JabawokJayUK/ProjectHaloUK/docs/gallery.md

# Gallery

## Fitted

The finished article — halo rings running as daytime running lights on a 159.

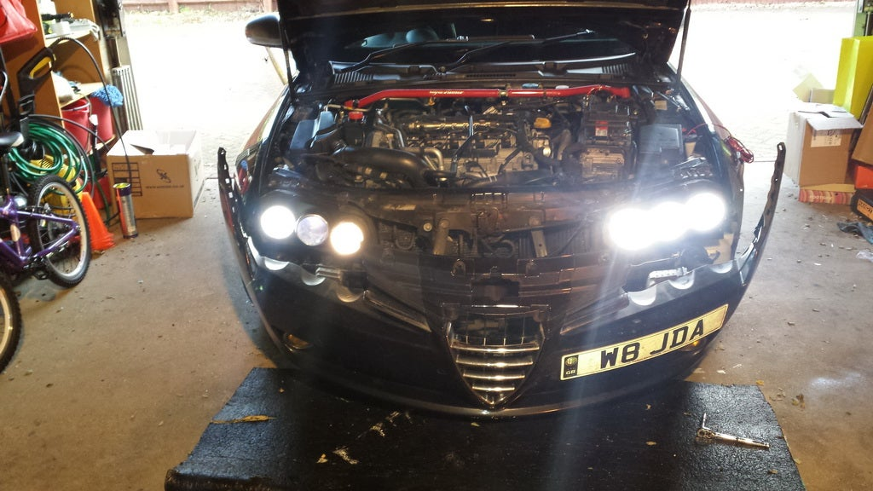
[picture p13: docs/images/gallery/fitted-01.jpg]
Fitted 1

Fitted 2
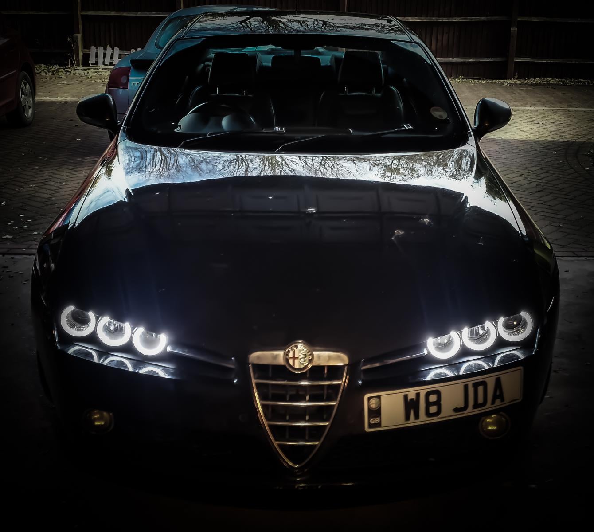
[picture p14: docs/images/gallery/fitted-03-hdr.jpg]
Fitted 3

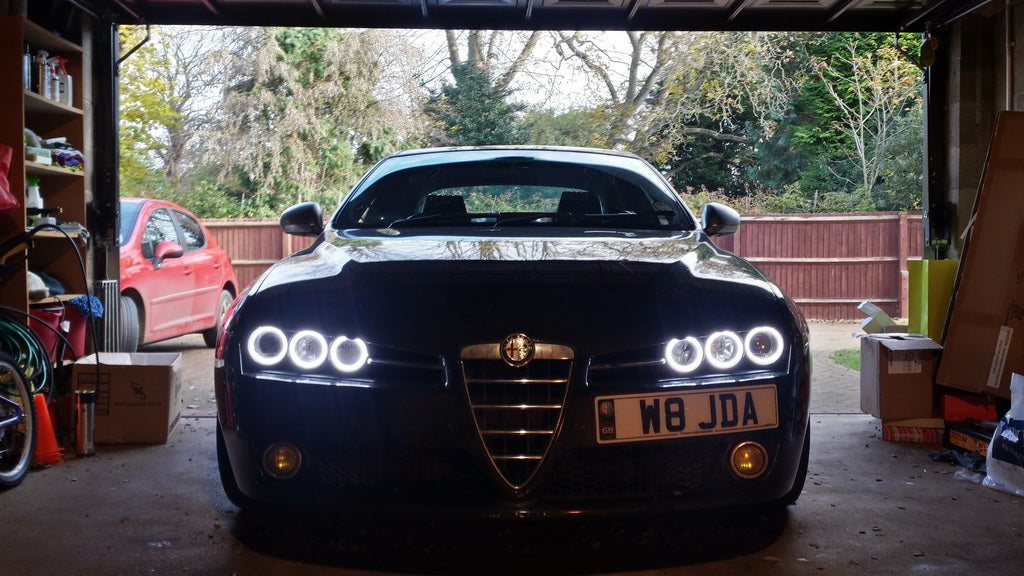
[picture p15: docs/images/gallery/fitted-04-hdr.jpg]
Fitted 4

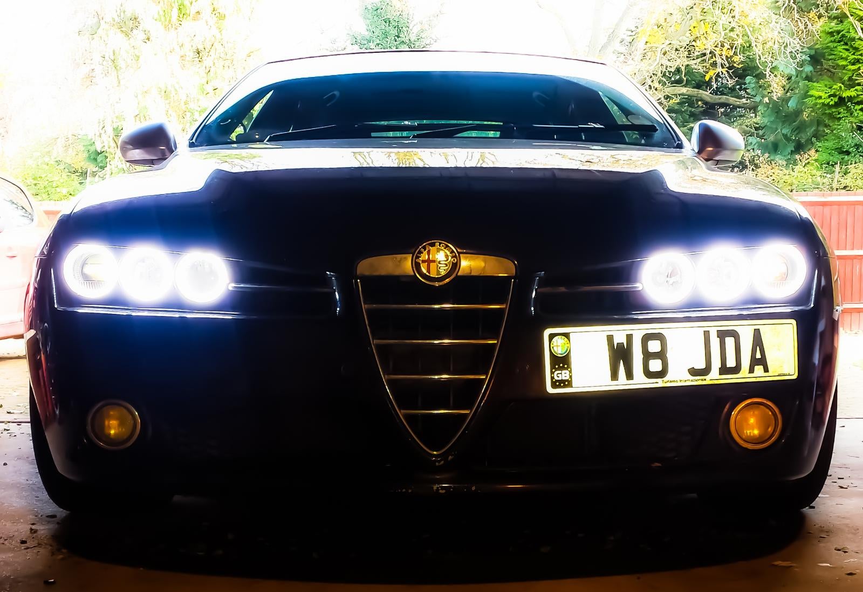
[picture p16: docs/images/gallery/fitted-05.jpg]
Fitted 5

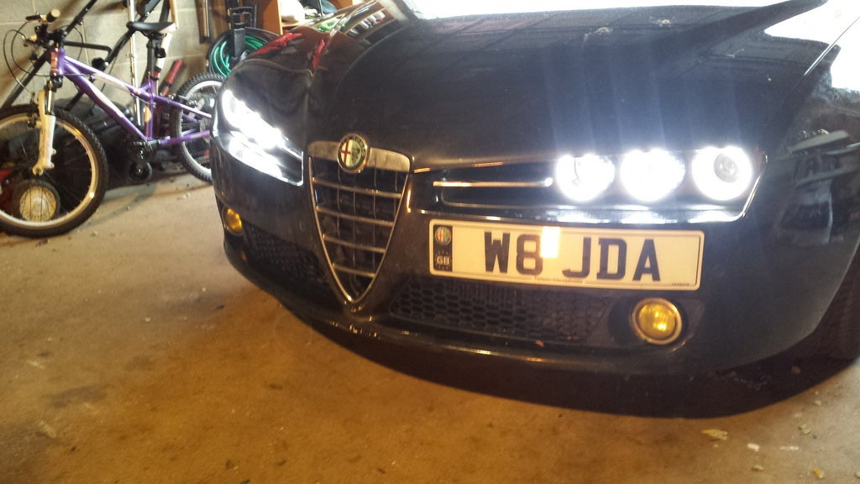
[picture p17: docs/images/gallery/fitted-06.jpg]
Fitted 6

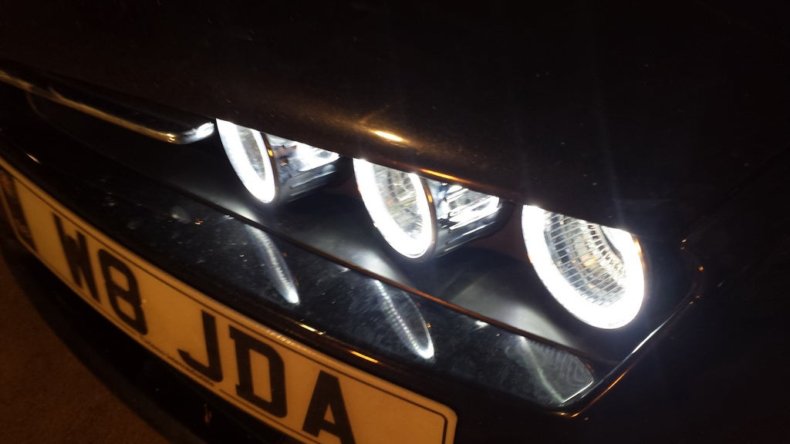
[picture p18: docs/images/gallery/fitted-07.jpg]
Fitted 7

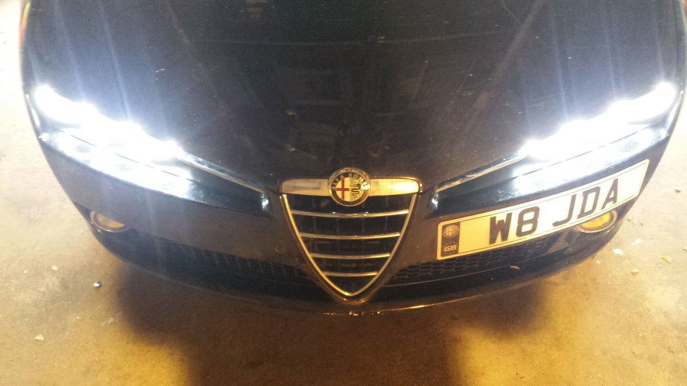
[picture p19: docs/images/gallery/fitted-08.jpg]
Fitted 8


## Development

Early ring testing in the dark, before any controller existed.

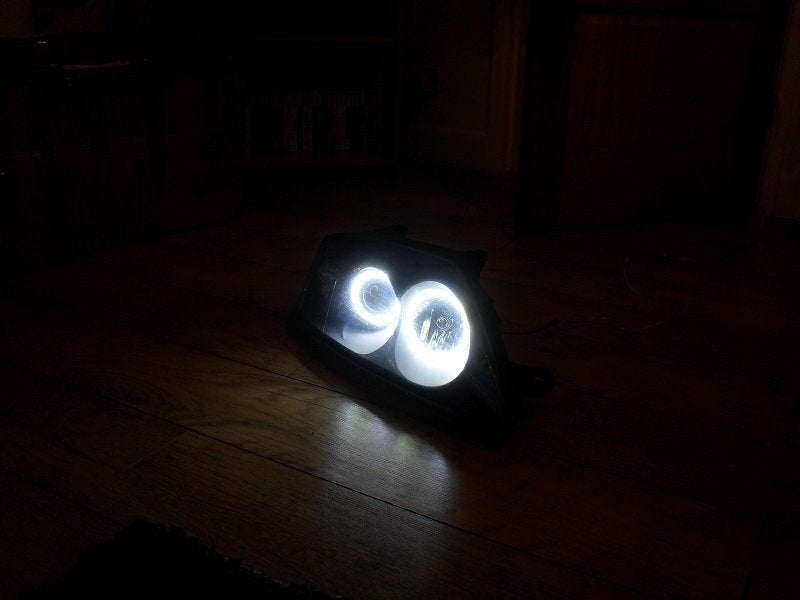
[picture p20: docs/images/gallery/early-ring-test-dark.jpg]
Early ring test


Component parts laid out.

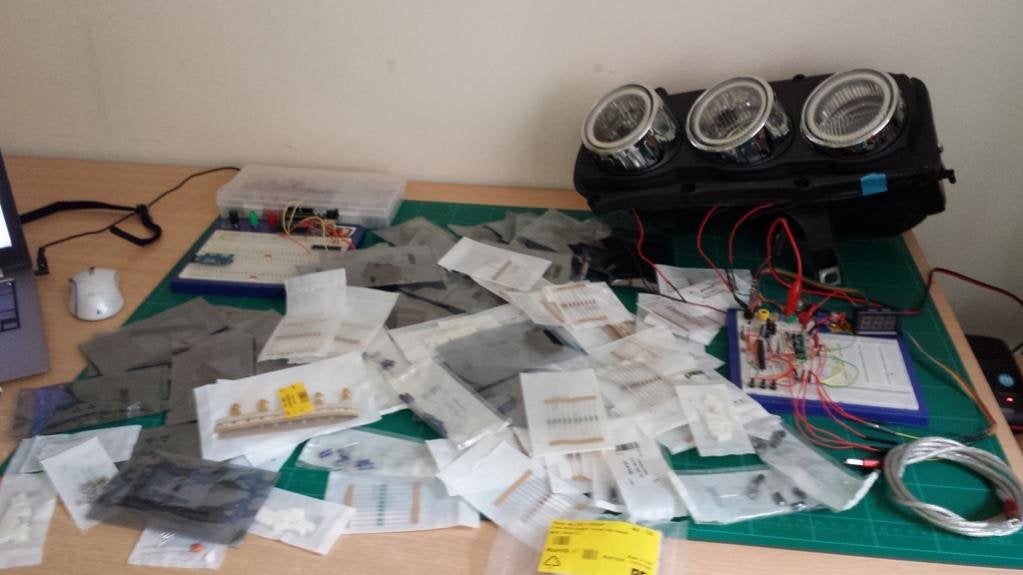
[picture p21: docs/images/controller/component-parts.jpg]
Component parts


Bench build — controllers wired up with rings for testing.

Bench build
Controllers and rings

## Hardware

v1 schematic, drawn in DesignSpark.

v1 schematic

v1 PCB layout.

v1 PCB

Controller I/O layout.

I/O layout

Firmware under development.

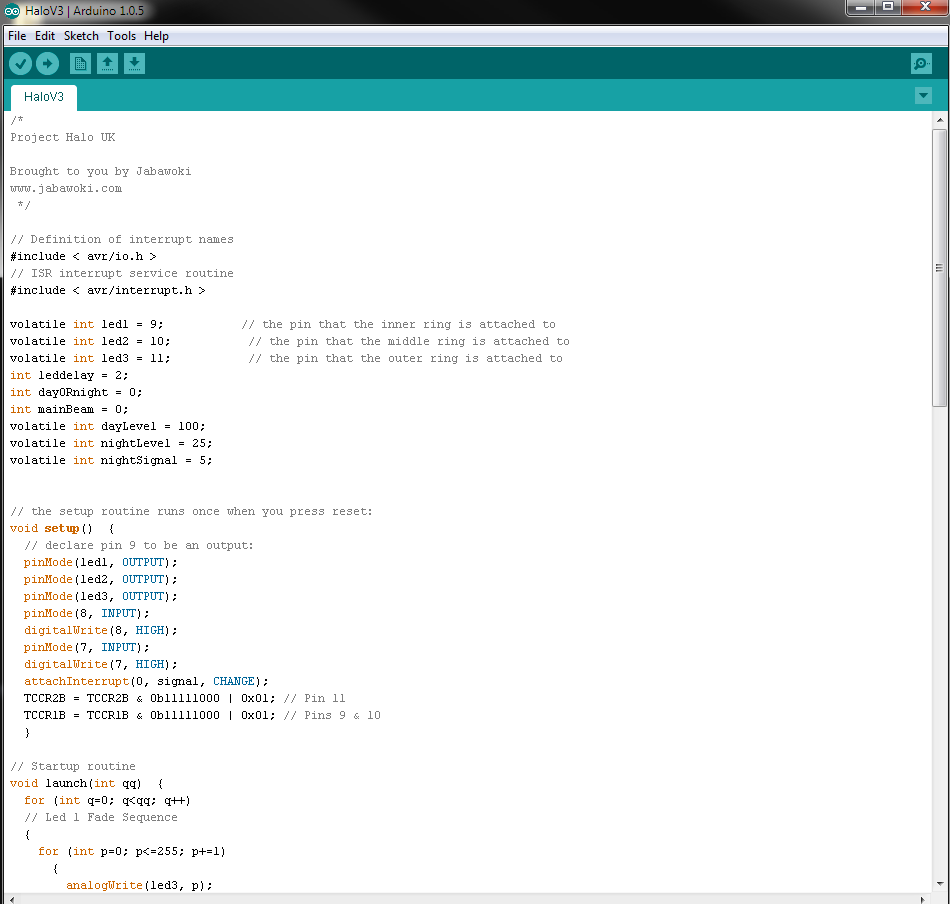
[picture p22: docs/images/controller/v1-code-screenshot.png]
Code


## Installation

Donor headlights, ready to be worked on.

Donor headlights

Bumper off, headlight location exposed.

Bumper removed
Headlight location

Power supply and relay installed in the engine bay.

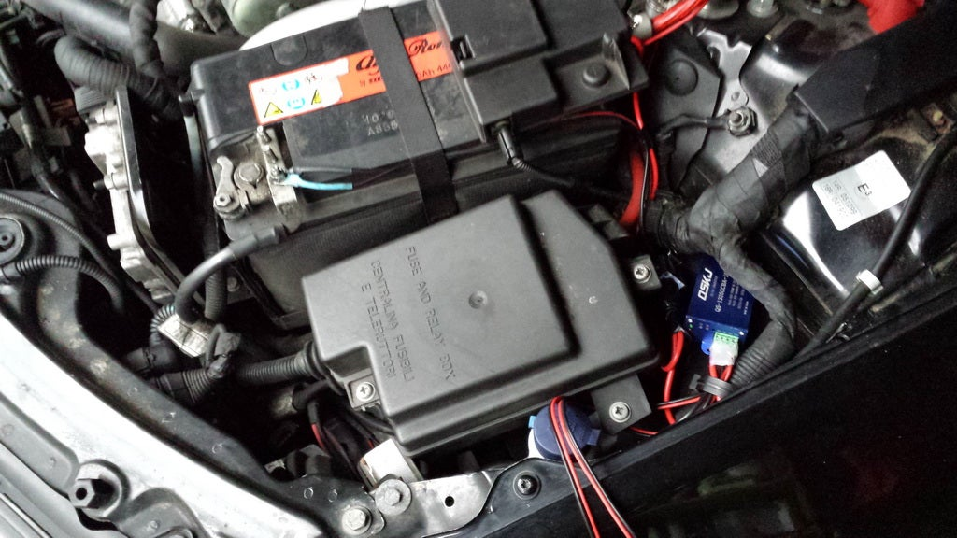
[picture p23: docs/images/power/engine-bay-psu-installed.jpg]
PSU installed

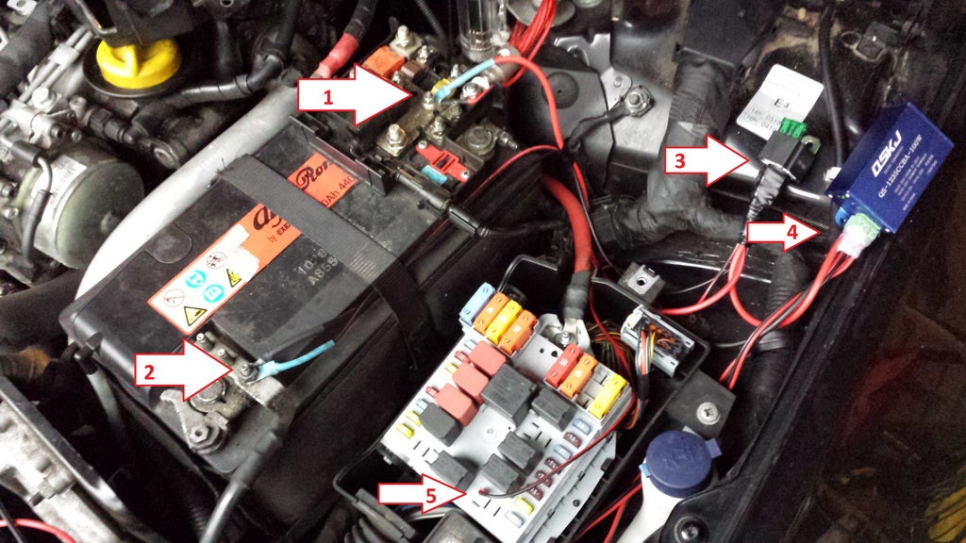
[picture p24: docs/images/power/engine-bay-annotated.jpg]
Engine bay annotated


## Camera originals

Full-resolution photos from the original shoots, in
[`images/originals/`](images/originals/).

### The boards

The bare v1 board, populated.

Bare board

A finished controller in its ABS case.

Controller in case

The buck converter that feeds the controllers.

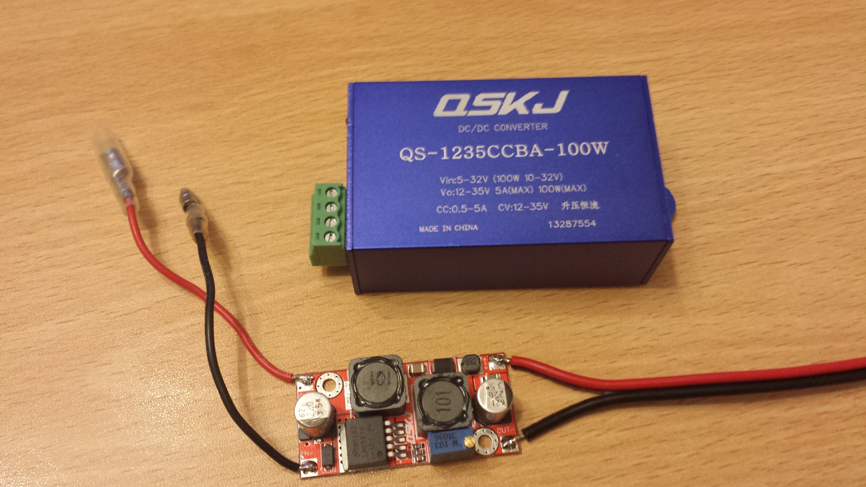
[picture p25: docs/images/originals/psu-buck-converter.jpg]
Buck converter


### Bench testing

Controllers and rings wired up on the bench.

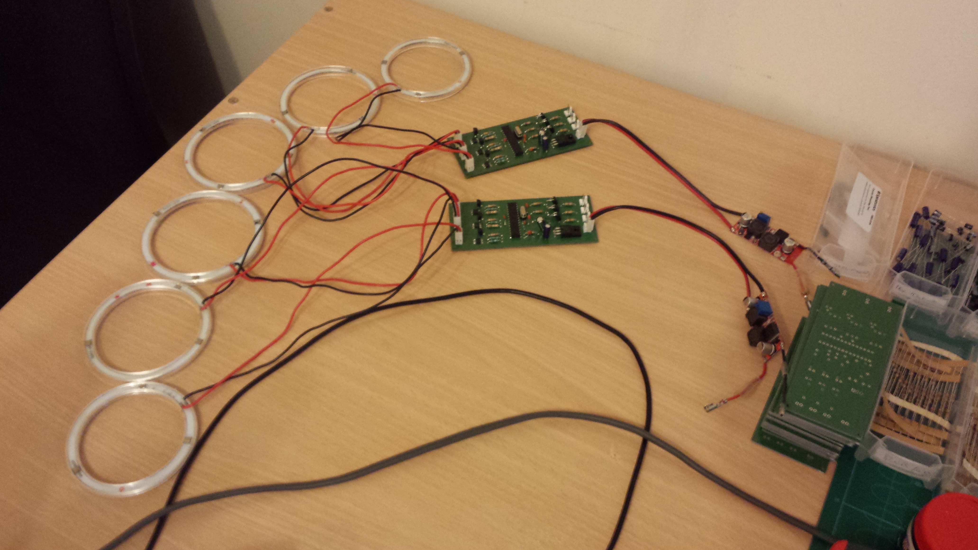
[picture p26: docs/images/originals/bench-rings-controllers.jpg]
Bench setup

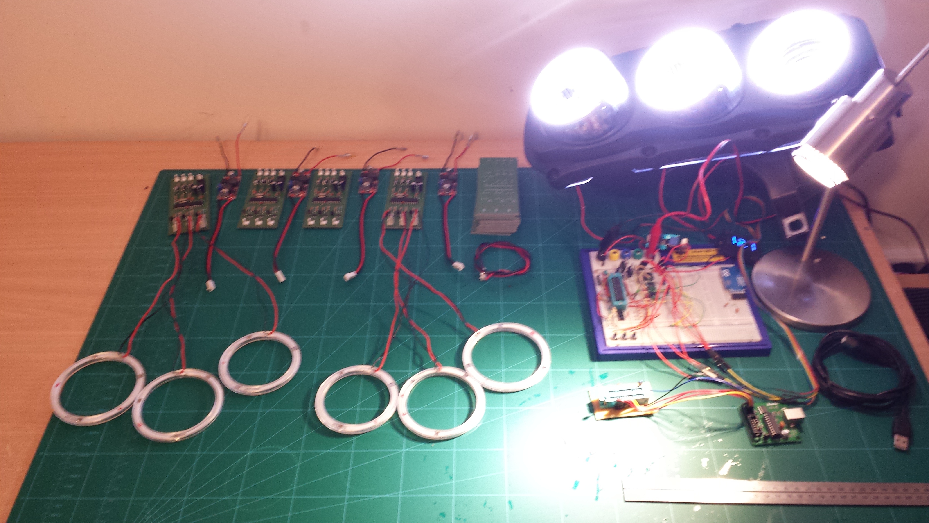
[picture p27: docs/images/originals/bench-rings-lit.jpg]
Rings lit

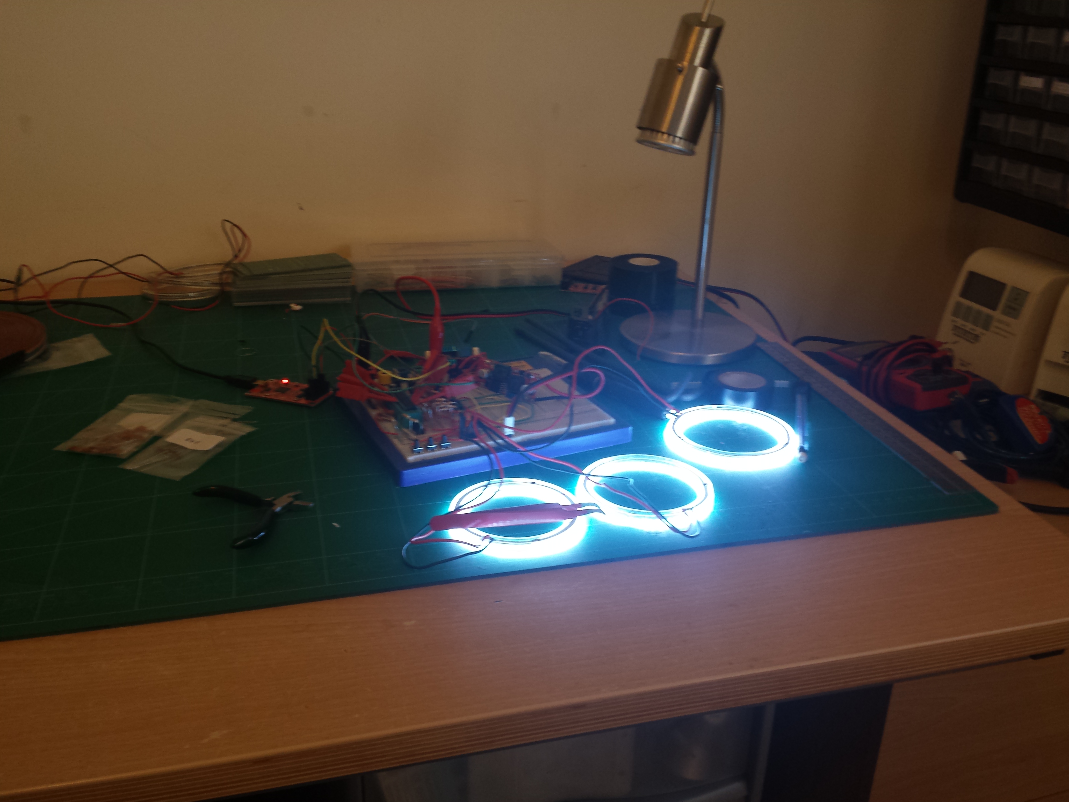
[picture p28: docs/images/originals/bench-test-lit.jpg]
Bench test lit


### Bumper off

The front bumper removed — the only way to reach the lower headlight mount.

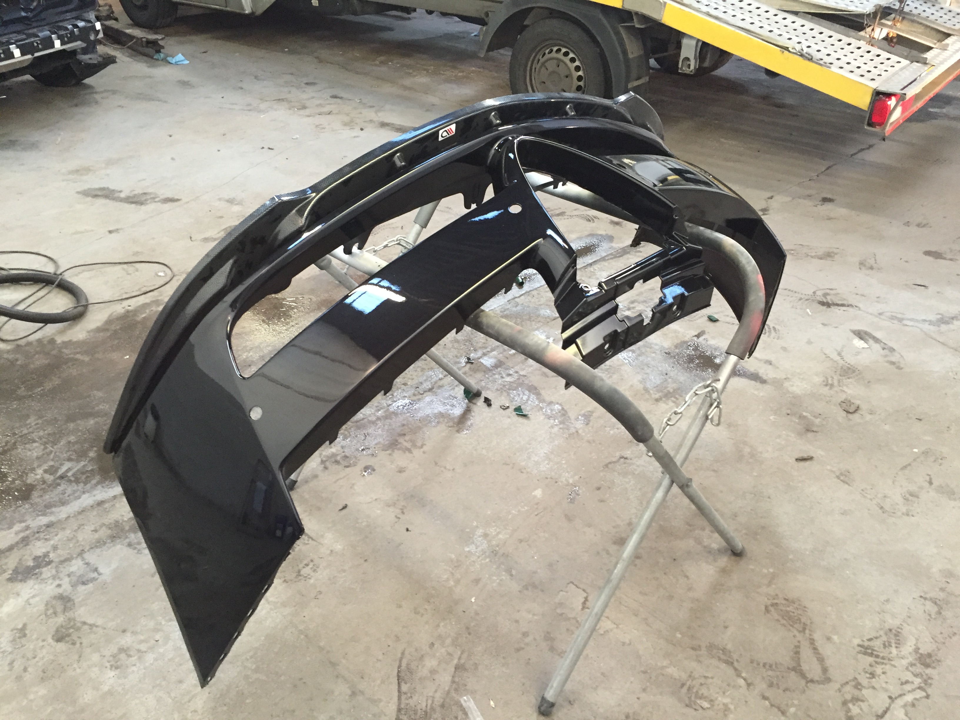
[picture p29: docs/images/originals/bumper-removed-01.jpg]
Bumper removed 1

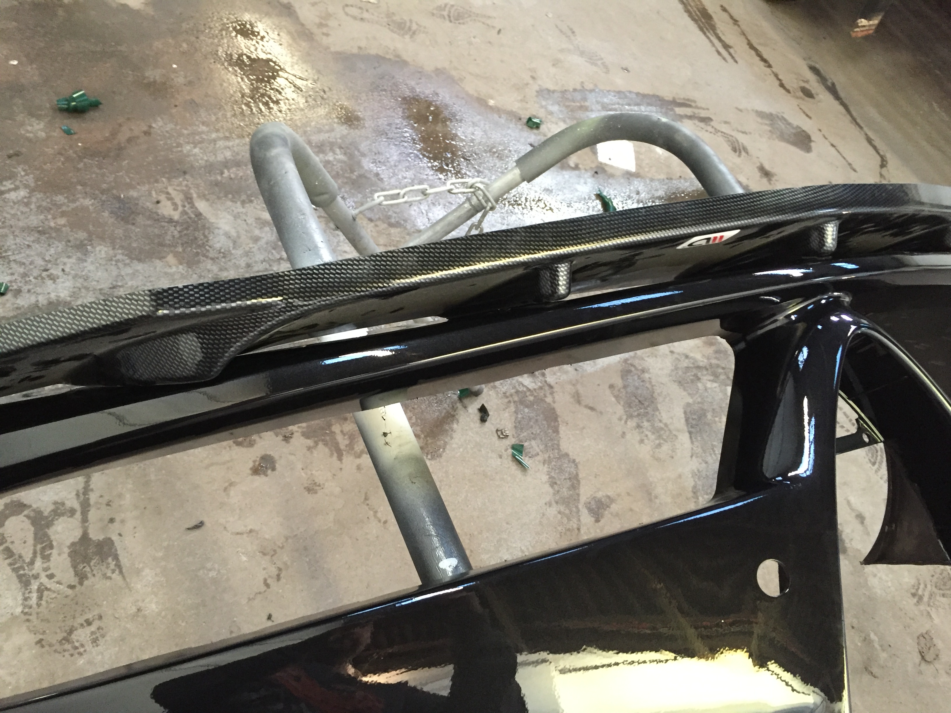
[picture p30: docs/images/originals/bumper-removed-02.jpg]
Bumper removed 2

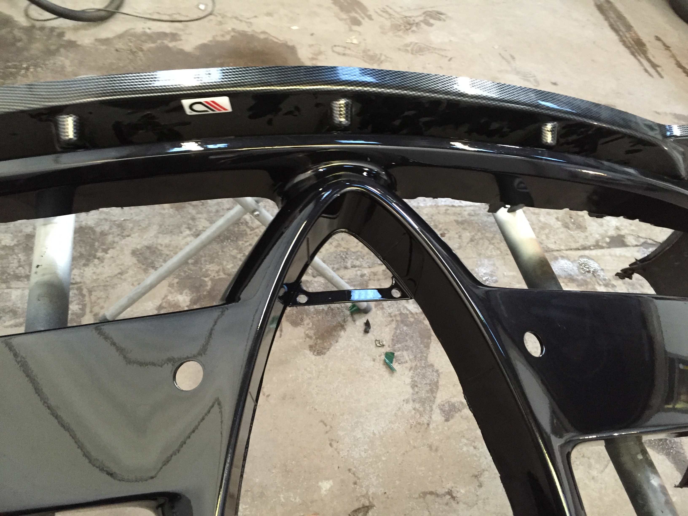
[picture p31: docs/images/originals/bumper-removed-03.jpg]
Bumper removed 3

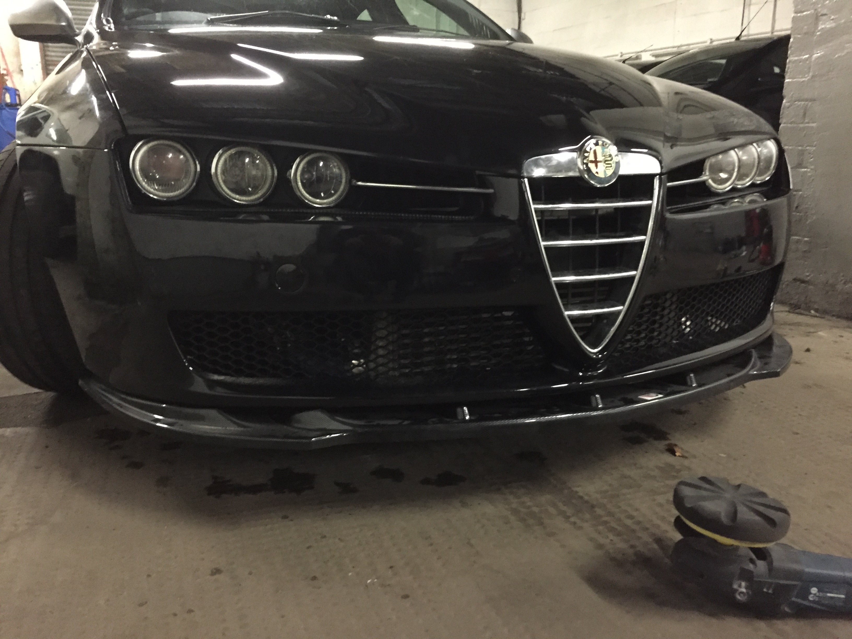
[picture p32: docs/images/originals/car-bumper-off-01.jpg]
Car with bumper off 1

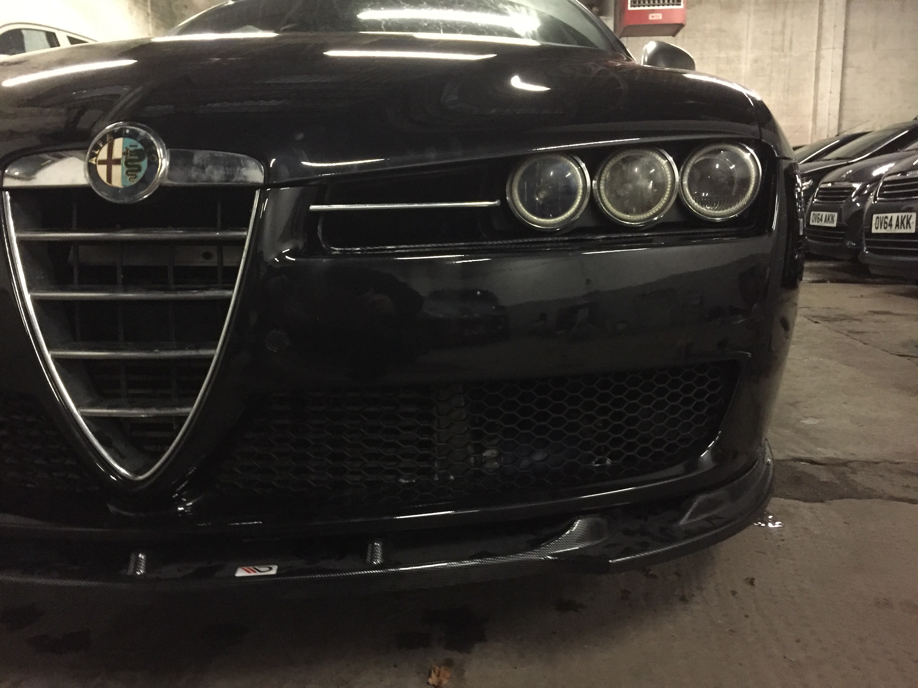
[picture p33: docs/images/originals/car-bumper-off-02.jpg]
Car with bumper off 2


### Fitted

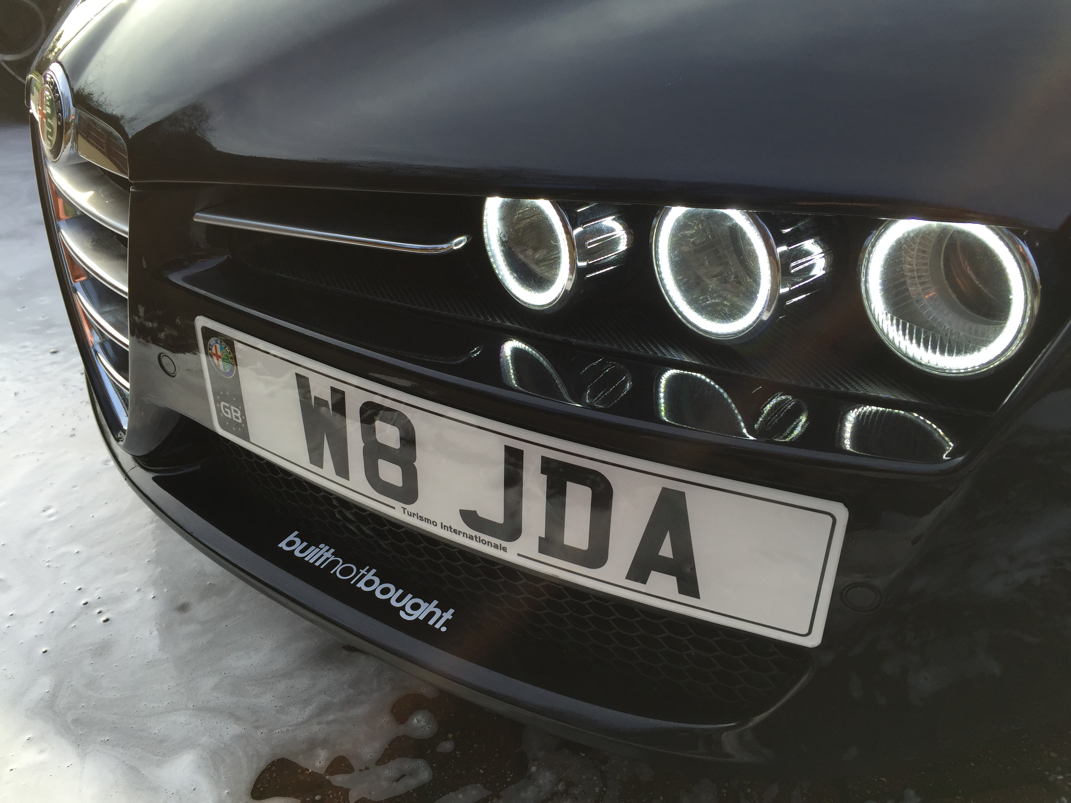
[picture p34: docs/images/originals/fitted-front-dusk.jpg]
Fitted, dusk

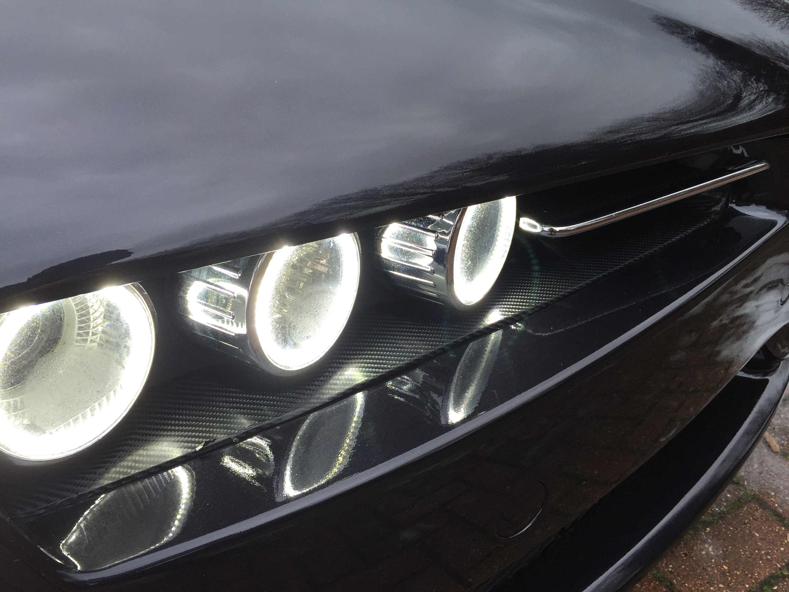
[picture p35: docs/images/originals/fitted-closeup-rings.jpg]
Close-up of rings

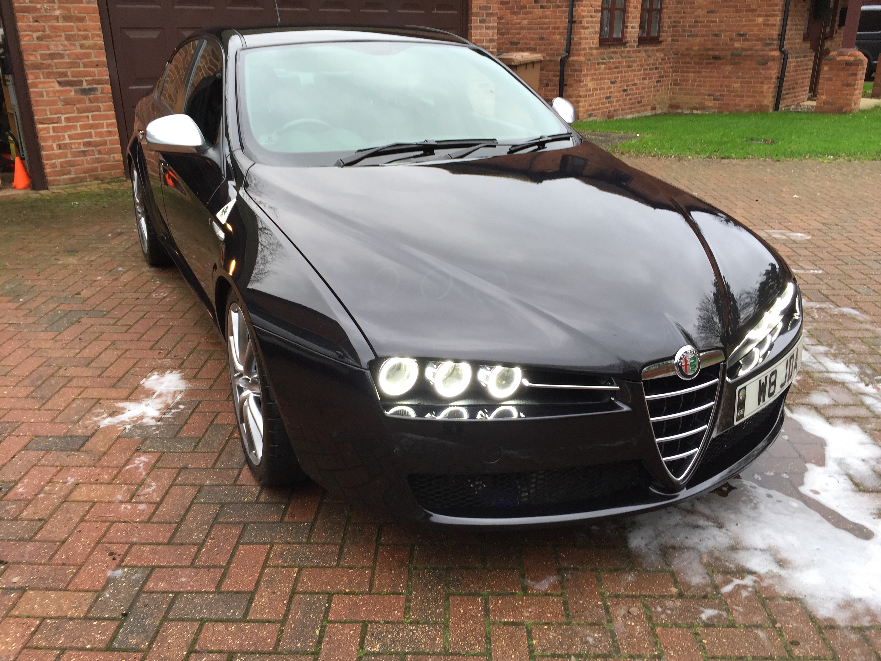
[picture p36: docs/images/originals/fitted-snow-wide.jpg]
Fitted in snow, wide

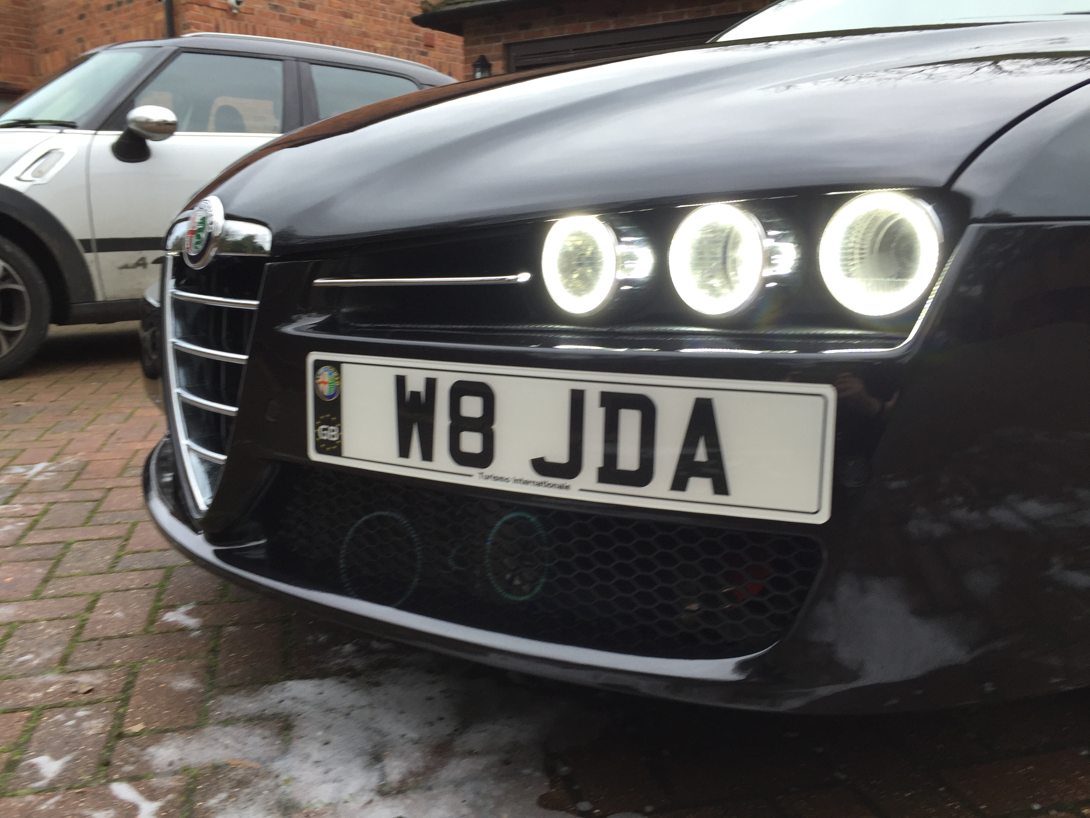
[picture p37: docs/images/originals/fitted-snow-front.jpg]
Fitted in snow, front

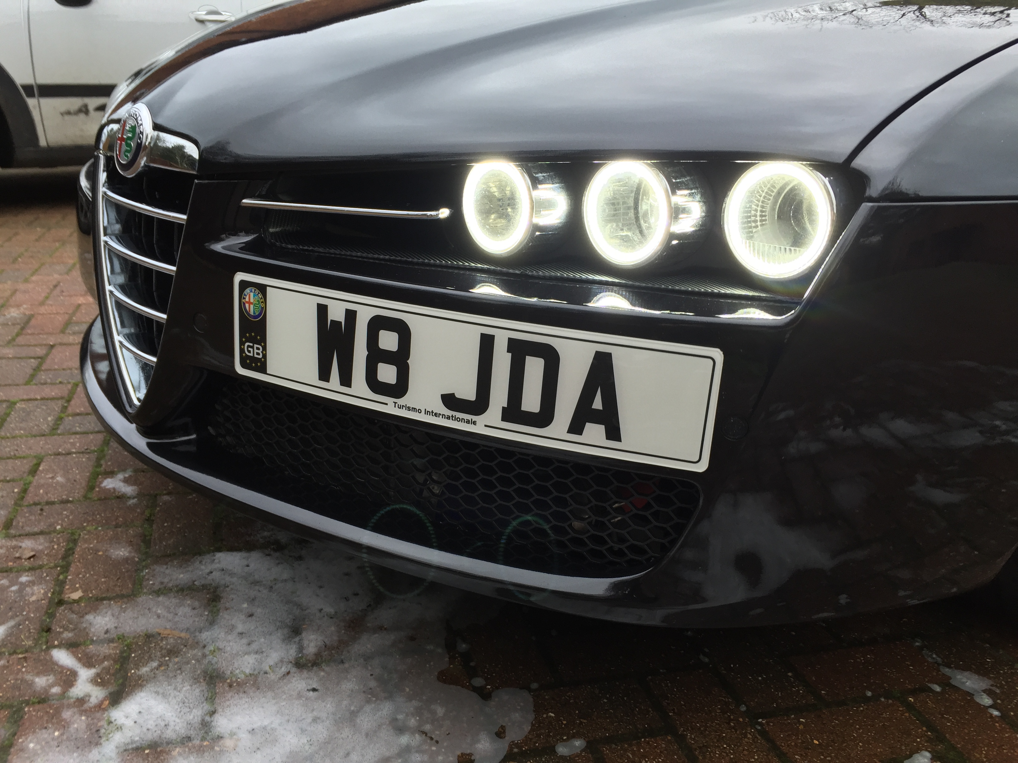
[picture p38: docs/images/originals/fitted-snow-plate.jpg]
Fitted in snow


## Ring colour reference

The difference between "white" (~5500 K) and "cold white" (~7000 K) rings.

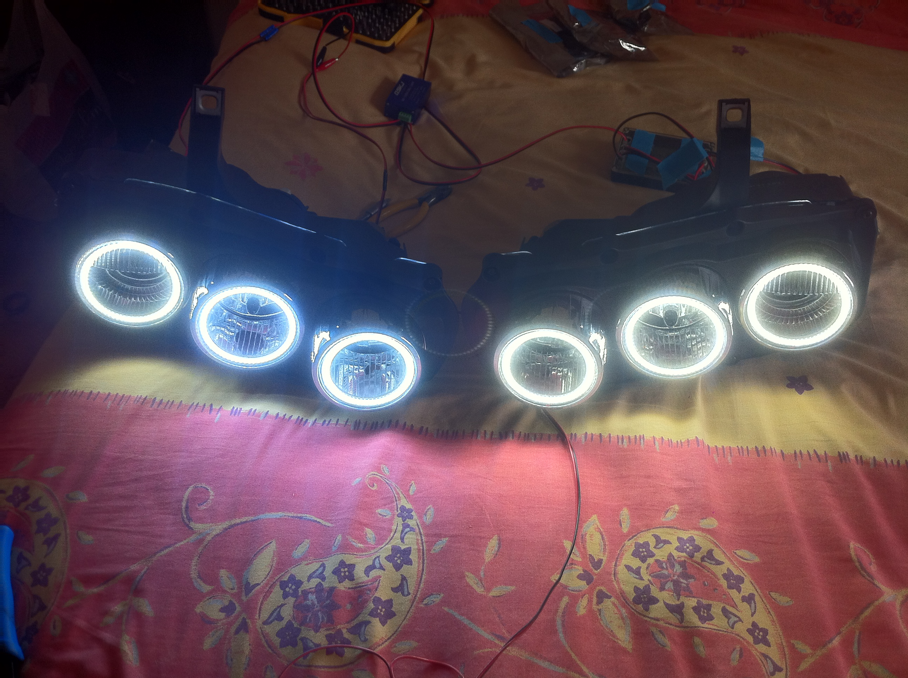
[picture p39: docs/images/gallery/ring-colour-temperature-comparison.jpg]
Ring colours


---

## Videos

Nine Project Halo videos are on YouTube — see [Videos](videos.md) for the full
list.

A community video by Coxy1, who worked out the headlight disassembly method:
[Alfa Romeo 159 Halo test](https://www.youtube.com/watch?v=qOf9f99d9EU).

---

*Photographs recovered from jabawoki.com and the
[Alfaowner.com build thread](https://www.alfaowner.com/threads/project-halo-the-159-brera-spider-halo-drl-project.314184/).
Images remain the copyright of their respective contributors.*
