JabawokJayUK/ProjectHaloUK/docs/videos.md

# Videos

Nine Project Halo videos, all on the [JayAbbott_UK YouTube channel](https://www.youtube.com/@JayAbbott_UK).

## Concept and alpha

Early bench work — getting the idea off the ground, before any custom hardware existed.

- [Project Halo — Alpha — Initial Concepts](https://www.youtube.com/watch?v=yZMHfKTUxSM)
- [Project Halo — Alpha — Getting the concepts together](https://www.youtube.com/watch?v=SdkW_1acpUQ)
- [Project Halo — Alpha — Getting the concepts together (v2)](https://www.youtube.com/watch?v=-Vzyds8_WEo)
- [Project Halo — Alpha Testing](https://www.youtube.com/watch?v=t6NNaXqVmHo)

## Effects and ring tests

The startup fade sequence, and the colour-temperature comparison that settled which rings to use.

- [Project Halo — Alpha — Startup effects](https://www.youtube.com/watch?v=248dNoFAD7A)
- [Project Halo — 6K Rings Test](https://www.youtube.com/watch?v=dSU7cvTWB_Q)
- [Project Halo — 8K Rings Test](https://www.youtube.com/watch?v=7mJIelXVpTg)

The 6000 K and 8000 K tests are worth watching back to back — 8000 K reads noticeably
bluer. See [Parts List](parts-list.md) for the ring sizes and the colour decision.

## On the car

- [Project Halo — On Car Test](https://www.youtube.com/watch?v=-ryPAMjl98U)

## Programming

Flashing a controller in place, without pulling the board out of its case.

- [Project Halo — In System Programming](https://www.youtube.com/watch?v=IiaWAieWZrA)

See [Firmware](firmware.md) for the ISP header pinout and the sketch itself.

## Third-party references

Headlight splitting is the stage most likely to go wrong, and watching someone
else do it first is worth the time. Links to useful videos by other people are
collected in the [Headlight Splitting](guides/headlight-splitting.md) guide.
