JabawokJayUK/ProjectHaloUK/hardware/3d-render.pdf

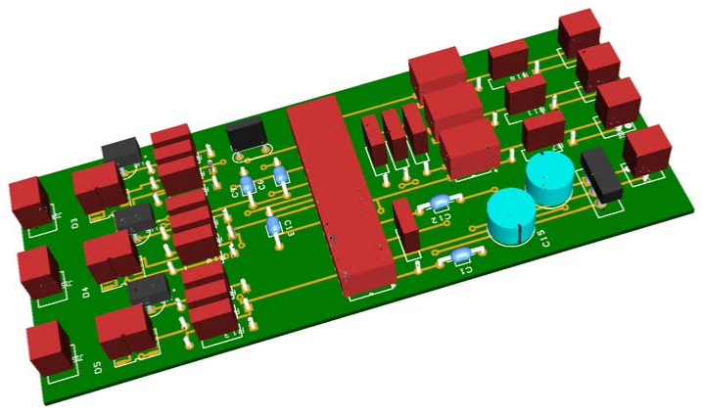
[picture p40: figure]
