JabawokJayUK/ProjectHaloUK/hardware/bom.xlsx

 |  |  |  |  |  |  |  |  | Estimate | Actual
Bill of Materials generated with DesignSpark PCB - www.DesignSpark.com/pcb |  |  |  |  |  |  |  | Cost to make 10 Sets of headlights | £1405.32 | £761.03
-------------------------------------------------------------------------- |  |  |  |  |  |  |  | Cost per set | £140.53 | £76.10
 |  |  |  |  |  |  |  | Cost per Headlight | £70.27 | £38.05
 |  |  |  |  |  |  |  |  |  |  |  |  | To make
Ref Name | Qty | Component | Value | Package | Manufacturer | MPN | Part Number | Description |  | VAT | Min Qty | Cost | 10 Sets of lights | Ordered | Actual Cost
RS Supply
U1 | 1 | 2N7000 |  | TO-92-3L | Fairchild Semiconductor | 2N7000 | 671-4733 | Trans MOSFET N-CH 60V 0.2A 3-Pin TO-92 | £0.08 | £0.02 | 20 | £1.87 | £1.87 | X | £202.39
U8 | 1 | 2N7000 |  | TO-92-3L | Fairchild Semiconductor | 2N7000 | 671-4733 | Trans MOSFET N-CH 60V 0.2A 3-Pin TO-92 | £0.08 | £0.02 | 20 | £1.87 | £1.87 | X
U9 | 1 | 2N7000 |  | TO-92-3L | Fairchild Semiconductor | 2N7000 | 671-4733 | Trans MOSFET N-CH 60V 0.2A 3-Pin TO-92 | £0.08 | £0.02 | 20 | £1.87 | £1.87 | X
J1 - Plug | 1 | 770602-2 |  | CONN_640456-2 | Tyco Electronics Amp | 770602-2 | 293-0026 | 2 way socket housing,2.54mm pitch | £0.11 | £0.02 | 10 | £1.32 | £2.64 | X
J2 - Plug | 1 | 770602-2 |  | CONN_640456-2 | Tyco Electronics Amp | 770602-2 | 293-0026 | 2 way socket housing,2.54mm pitch | £0.11 | £0.02 | 10 | £1.32 | £2.64 | X
J3 - Plug | 1 | 770602-2 |  | CONN_640456-2 | Tyco Electronics Amp | 770602-2 | 293-0026 | 2 way socket housing,2.54mm pitch | £0.11 | £0.02 | 10 | £1.32 | £2.64 | X
J4 - Plug | 1 | 770602-2 |  | CONN_640456-2 | Tyco Electronics Amp | 770602-2 | 293-0026 | 2 way socket housing,2.54mm pitch | £0.11 | £0.02 | 10 | £1.32 | £2.64 | X
J5 - Plug | 1 | 770602-2 |  | CONN_640456-2 | Tyco Electronics Amp | 770602-2 | 293-0026 | 2 way socket housing,2.54mm pitch | £0.11 | £0.02 | 10 | £1.32 | £2.64 | X
J6 - Plug | 1 | 770602-2 |  | CONN_640456-2 | Tyco Electronics Amp | 770602-2 | 293-0026 | 2 way socket housing,2.54mm pitch | £0.11 | £0.02 | 10 | £1.32 | £2.64 | X
J7 - Plug | 1 | 770602-2 |  | CONN_640456-2 | Tyco Electronics Amp | 770602-2 | 293-0026 | 2 way socket housing,2.54mm pitch | £0.11 | £0.02 | 10 | £1.32 | £2.64 | X
J1 | 1 | 640456-2 |  | CONN_640456-2 | Tyco Electronics Amp | 640456-2 | 1320355 | 2 way MTA straight friction lock header | £0.12 | £0.02 | 10 | £1.44 | £2.88 | X
J2 | 1 | 640456-2 |  | CONN_640456-2 | Tyco Electronics Amp | 640456-2 | 1320355 | 2 way MTA straight friction lock header | £0.12 | £0.02 | 10 | £1.44 | £2.88 | X
J3 | 1 | 640456-2 |  | CONN_640456-2 | Tyco Electronics Amp | 640456-2 | 1320355 | 2 way MTA straight friction lock header | £0.12 | £0.02 | 10 | £1.44 | £2.88 | X
J4 | 1 | 640456-2 |  | CONN_640456-2 | Tyco Electronics Amp | 640456-2 | 1320355 | 2 way MTA straight friction lock header | £0.12 | £0.02 | 10 | £1.44 | £2.88 | X
J5 | 1 | 640456-2 |  | CONN_640456-2 | Tyco Electronics Amp | 640456-2 | 1320355 | 2 way MTA straight friction lock header | £0.12 | £0.02 | 10 | £1.44 | £2.88 | X
J6 | 1 | 640456-2 |  | CONN_640456-2 | Tyco Electronics Amp | 640456-2 | 1320355 | 2 way MTA straight friction lock header | £0.12 | £0.02 | 10 | £1.44 | £2.88 | X
J7 | 1 | 640456-2 |  | CONN_640456-2 | Tyco Electronics Amp | 640456-2 | 1320355 | 2 way MTA straight friction lock header | £0.12 | £0.02 | 10 | £1.44 | £2.88 | X
U6 | 1 | ATMEGA328P-PU |  | 28P3 | Atmel | ATMEGA328P-PU | 6962260 | Microcontroller AVR 32K FLASH 2K SRAM | £3.19 | £0.64 | 1 | £3.83 | £76.56 | X
C1 | 1 | Capacitor | 1nF | DSC | CERA MITE | 30LVD10 7.5PCM | 214-5931 | Y2 suppression cap,1nF 250Vac | £0.48 | £0.10 | 5 | £2.88 | £11.52 | X
C12 | 1 | Capacitor | 1nF | DSC | CERA MITE | 30LVD10 7.5PCM | 214-5931 | Y2 suppression cap,1nF 250Vac | £0.48 | £0.10 | 5 | £2.88 | £11.52 | X
C13 | 1 | Capacitor | 1nF | DSC | CERA MITE | 30LVD10 7.5PCM | 214-5931 | Y2 suppression cap,1nF 250Vac | £0.48 | £0.10 | 5 | £2.88 | £11.52 | X
C6 | 1 | Capacitor | 22pF | DSC | Vishay | VY1220K31U2JQ6TV0 | 736-8833 | X1/Y1 Disc Ceramic Cap,U2J,22pF 500Vac | £0.24 | £0.05 | 10 | £2.88 | £5.76 | X
C9 | 1 | Capacitor | 22pF | DSC | Vishay | VY1220K31U2JQ6TV0 | 736-8833 | X1/Y1 Disc Ceramic Cap,U2J,22pF 500Vac | £0.24 | £0.05 | 10 | £2.88 | £5.76 | X
C15 | 1 | Capacritor_Pol | 10uF | DSCV | Panasonic | ECA1CM100 | 228-6622 | M radial Al elect cap,10uF 16V 85deg C | £0.07 | £0.01 | 5 | £0.42 | £1.68 | X
C7 | 1 | Capacritor_Pol | 100uF | DSCV | Panasonic | ECA1EHG101 | 365-4127 | NHG min Al electrolytic cap,100uF 25V | £0.14 | £0.03 | 5 | £0.82 | £3.26 | X
R12 | 1 | CFR25J2R2 | 2R2 | RES_CFR25_TYCO | Tyco Electronics | CFR25J2R2 | 135572 | CFR25 carbon film resistor,2R2 0.33W | £0.01 | £0.003 | 10 | £0.18 | £0.36 | X
R1 | 1 | CFR25J10K | 10K | RES_CFR25_TYCO | Tyco Electronics | CFR25J10K | 131378 | CFR25 carbon film resistor,10K 0.33W | £0.01 | £0.003 | 10 | £0.18 | £0.36 | X
R4 | 1 | CFR25J10K | 10K | RES_CFR25_TYCO | Tyco Electronics | CFR25J10K | 131378 | CFR25 carbon film resistor,10K 0.33W | £0.01 | £0.003 | 10 | £0.18 | £0.36 | X
R3 | 1 | CFR25J10K | 10K | RES_CFR25_TYCO | Tyco Electronics | CFR25J10K | 131378 | CFR25 carbon film resistor,10K 0.33W | £0.01 | £0.003 | 10 | £0.18 | £0.36 | X
R2 | 1 | CFR25J10K | 10K | RES_CFR25_TYCO | Tyco Electronics | CFR25J10K | 131378 | CFR25 carbon film resistor,10K 0.33W | £0.01 | £0.003 | 10 | £0.18 | £0.36 | X
R5 | 1 | CFR25J10K | 10K | RES_CFR25_TYCO | Tyco Electronics | CFR25J10K | 131378 | CFR25 carbon film resistor,10K 0.33W | £0.01 | £0.003 | 10 | £0.18 | £0.36 | X
R6 | 1 | CFR25J10K | 10K | RES_CFR25_TYCO | Tyco Electronics | CFR25J10K | 131378 | CFR25 carbon film resistor,10K 0.33W | £0.01 | £0.003 | 10 | £0.18 | £0.36 | X
R8 | 1 | CFR25J10K | 10K | RES_CFR25_TYCO | Tyco Electronics | CFR25J10K | 131378 | CFR25 carbon film resistor,10K 0.33W | £0.01 | £0.003 | 10 | £0.18 | £0.36 | X
R7 | 1 | CFR25J820R | 820R | RES_CFR25_TYCO | Tyco Electronics | CFR25J820R | 131249 | CFR25 carbon film resistor,820R 0.33W | £0.01 | £0.003 | 10 | £0.18 | £0.36 | X
R11 | 1 | CFR25J820R | 820R | RES_CFR25_TYCO | Tyco Electronics | CFR25J820R | 131249 | CFR25 carbon film resistor,820R 0.33W | £0.01 | £0.003 | 10 | £0.18 | £0.36 | X
R18 | 1 | CFR25J820R | 820R | RES_CFR25_TYCO | Tyco Electronics | CFR25J820R | 131249 | CFR25 carbon film resistor,820R 0.33W | £0.01 | £0.003 | 10 | £0.18 | £0.36 | X
U2 | 1 | L7805ABP |  | TO-220FP | STMicroelectronics | L7805ABP | 6869726 | Voltage Regulator 5V 1A TO-220FP | £1.05 | £0.21 | 10 | £12.64 | £25.27 | X
R15 | 1 | LR1F2R0 | 2R | RES_LR1_TYCO | Tyco Electronics | LR1F2R0 | 150638 | Metal film resistor,2R 0.6W | £0.11 | £0.02 | 10 | £1.32 | £2.64 | X
R16 | 1 | LR1F2R0 | 2R | RES_LR1_TYCO | Tyco Electronics | LR1F2R0 | 150638 | Metal film resistor,2R 0.6W | £0.11 | £0.02 | 10 | £1.32 | £2.64 | X
R9 | 1 | LR1F110K | 110K | RES_LR1_TYCO | Tyco Electronics | LR1F110K | 148988 | Metal film resistor,110K 0.6W | £0.03 | £0.01 | 10 | £0.36 | £0.72 | X
R10 | 1 | LR1F110K | 110K | RES_LR1_TYCO | Tyco Electronics | LR1F110K | 148988 | Metal film resistor,110K 0.6W | £0.03 | £0.01 | 10 | £0.36 | £0.72 | X
R13 | 1 | LR1F110K | 110K | RES_LR1_TYCO | Tyco Electronics | LR1F110K | 148988 | Metal film resistor,110K 0.6W | £0.03 | £0.01 | 10 | £0.36 | £0.72 | X
D3 | 1 | NUD4001 |  | SM | ON Semiconductor | NUD4001DR2G | 646-6529 | High Current LED Driver | £0.79 | £0.16 | 10 | £9.48 | £18.96 | X
D4 | 1 | NUD4001 |  | SM | ON Semiconductor | NUD4001DR2G | 646-6529 | High Current LED Driver | £0.79 | £0.16 | 10 | £9.48 | £18.96 | X
D5 | 1 | NUD4001 |  | SM | ON Semiconductor | NUD4001DR2G | 646-6529 | High Current LED Driver | £0.79 | £0.16 | 10 | £9.48 | £18.96 | X
XTAL1 | 1 | XTAL | 16 | DSC | RALTRON | HC49S | 693-6970 | Crystal 16.000MHz | £0.21 | £0.04 | 10 | £2.56 | £5.11 | X
Delivery charge RS |  |  |  |  |  |  |  |  | £5.00 | £0.00 | 1 | £5.00 | £5.00 | X
J1/2/3/4/5/6/7 Pins | 1 | 58517-1 |  |  | TE Connectivity |  | 293-0111 | Crimping tool for CST 100 connector | £273.00 | £54.60 | 1 | £327.60 | £327.60 | X | £368.88
J1/2/3/4/5/6/7 Pins | 1 | 770666-1 |  |  |  |  | 293-0098 | Tin plated crimp contact | £0.11 | £0.02 | 50 | £6.84 | £19.15 | X
Farnell Supply
U3 | 1 | FOD817 |  | MDIP-4L | Fairchild Semiconductor | FOD852 | 1495371 | Optocoupler Transistor 50-600% DIP4 (farnell) | £0.48 | £0.10 | 5 | £2.88 | £11.52 | X | £48.96
U4 | 1 | FOD817 |  | MDIP-4L | Fairchild Semiconductor | FOD852 | 1495371 | Optocoupler Transistor 50-600% DIP4 (farnell) | £0.48 | £0.10 | 5 | £2.88 | £11.52 | X
U5 | 1 | FOD817 |  | MDIP-4L | Fairchild Semiconductor | FOD852 | 1495371 | Optocoupler Transistor 50-600% DIP4 (farnell) | £0.48 | £0.10 | 5 | £2.88 | £11.52 | X
Delivery charge Farnell | 1 |  |  |  |  |  |  |  | £0.00 | £0.00 | 1 | £0.00 | £0.00
PCB Train Supply
PCB Etched | 1 | N/A | N/A | N/A | PCBTrain | www.pcbtrain.co.uk |  | Etched PCB ready to solder | £6.00 | £0.00 | 24 | £144.00 | £120.00 | X | £140.80
Delivery Charge PCB Train | 1 |  |  |  |  |  |  |  | £5.00 | £0.00 | 1 | £5.00 | £5.00 | X
Ebay
ABS Case 120 x 70 x 30 | 1 | G091 |  |  |  |  |  | ABS CASE -PLASTIC BOX -PLASTIC CASE - 120x70x30mm G091 | £3.85 | £0.00 | 1 | £3.85 | £77.00
 |  |  |  |  |  |  |  | Delivery for above |  |  |  |  | £6.30
PSU | 1 |  |  |  |  |  |  | DC Boost Buck Voltage Converter 3-35V to 1.25-30V 2A Full Range Regulator LM2587 | £5.26 | £0.00 | 1 | £5.26 | £105.20
Alibaba
95MM(outer diameter=95mm) 66-SMD 3528 LED Cool White Light Car Angel Eyes Daytime Running Light Lamp (9~30V / 2 PCS/lot) |  |  |  |  |  |  |  |  | £14.50 | £0.00 | 1 | £14.50 | £145.00
90MM(outer diameter=90mm) 63-SMD 3528 LED Cool White Light Car Angel Eyes Daytime Running Light Lamp (9~30V / 2 PCS) |  |  |  |  |  |  |  |  | £14.50 | £0.00 | 1 | £14.50 | £145.00
85MM(outer diameter=85mm) 63-SMD 3528 LED Cool White LightDaytime Running Light Lamp (9~30V / 2 PCS) |  |  |  |  |  |  |  |  | £14.50 | £0.00 | 1 | £14.50 | £145.00
