JabawokJayUK/ProjectHaloUK/(threads)

Thread 1 (2019-08-01):

avrdude issue

nindidooo, 2019-08-01:
hey Jay, could you please tell me what board to select in arduino to make this work?
I assume you used arduino as ISP to program the board - is this right?

My setup is: arduino uno used as arduino as ISP programmer, connected up to the 6 pins on the project halo board. I am unable to connect nor program the device and get this error:

avrdude: stk500_getparm(): (a) protocol error, expect=0x14, resp=0x14

avrdude: stk500_getparm(): (a) protocol error, expect=0x14, resp=0x01
avrdude: stk500_initialize(): (a) protocol error, expect=0x14, resp=0x10
avrdude: initialization failed, rc=-1
         Double check connections and try again, or use -F to override
         this check.

avrdude: stk500_disable(): unknown response=0x12
the selected serial port avrdude: stk500_disable(): unknown response=0x12
 does not exist or your board is not connected
