JabawokJayUK/ProjectHaloUK/hardware/pcb-layout.pdf

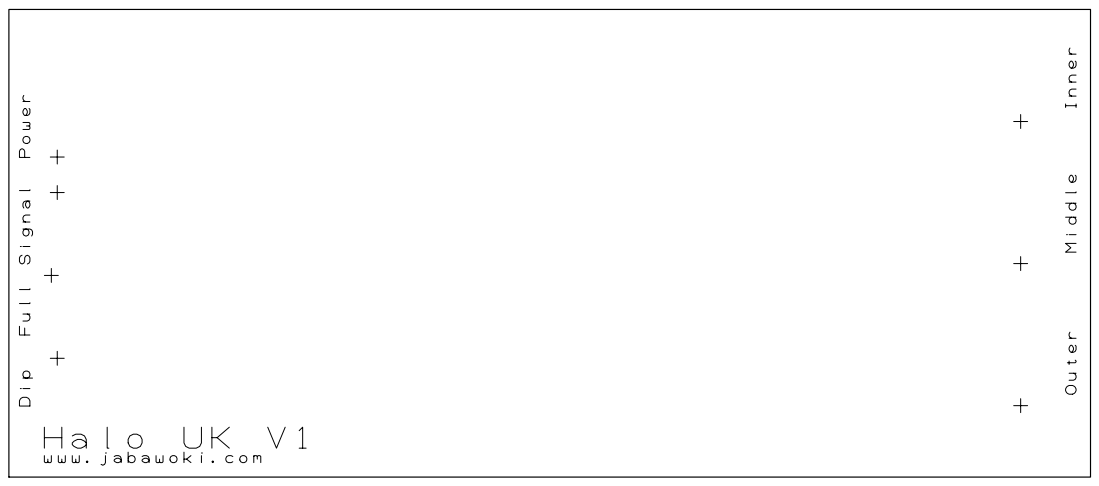
[picture p53: page 1]

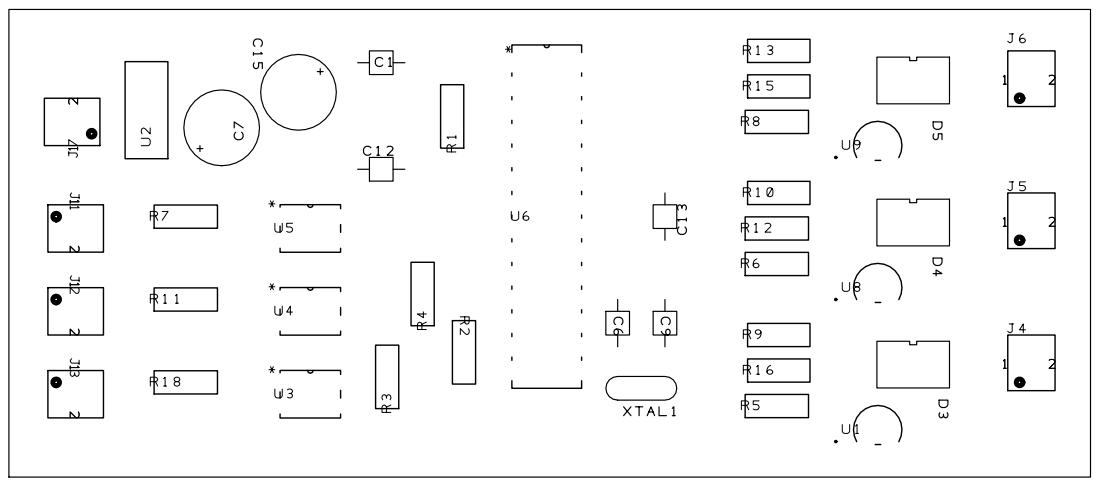
[picture p54: page 2]

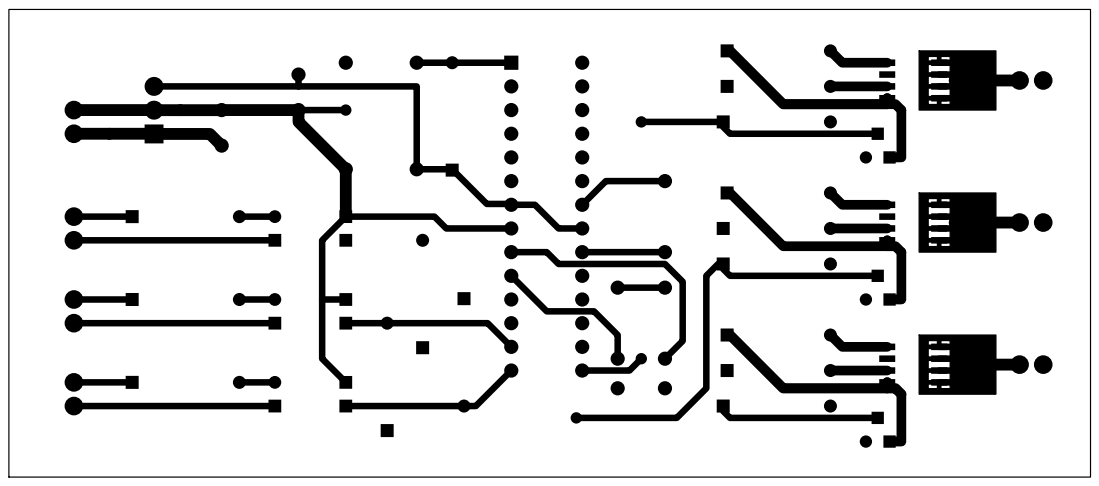
[picture p55: page 3]

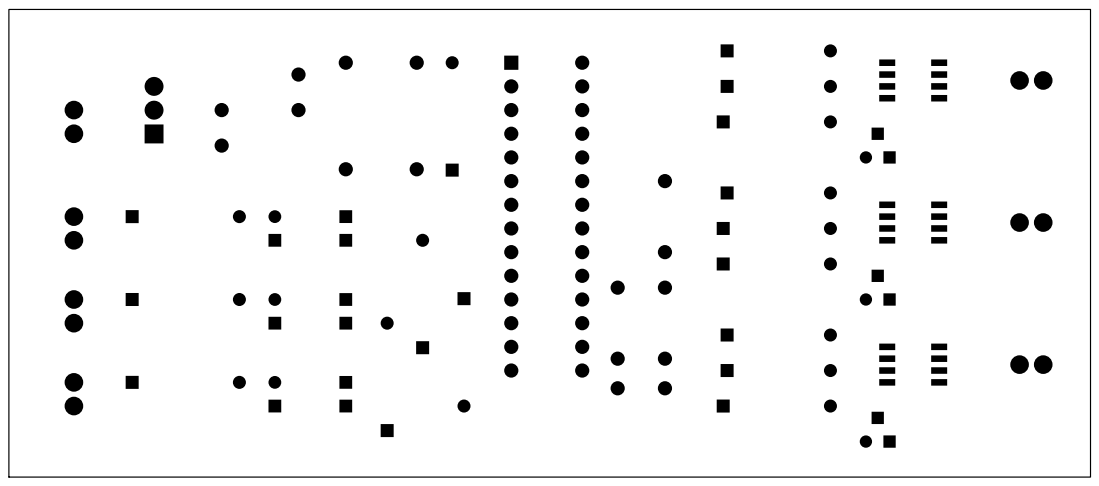
[picture p56: page 4]

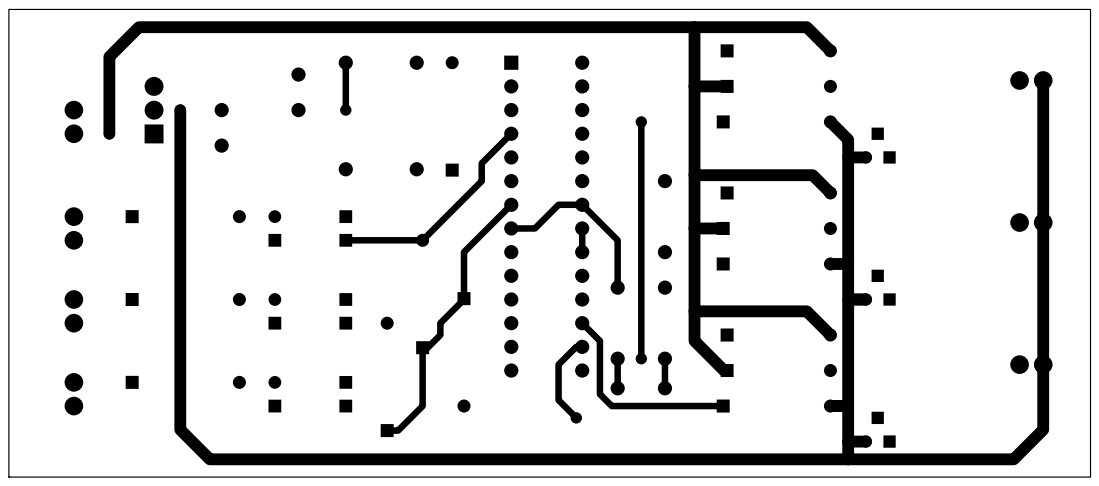
[picture p57: page 6]

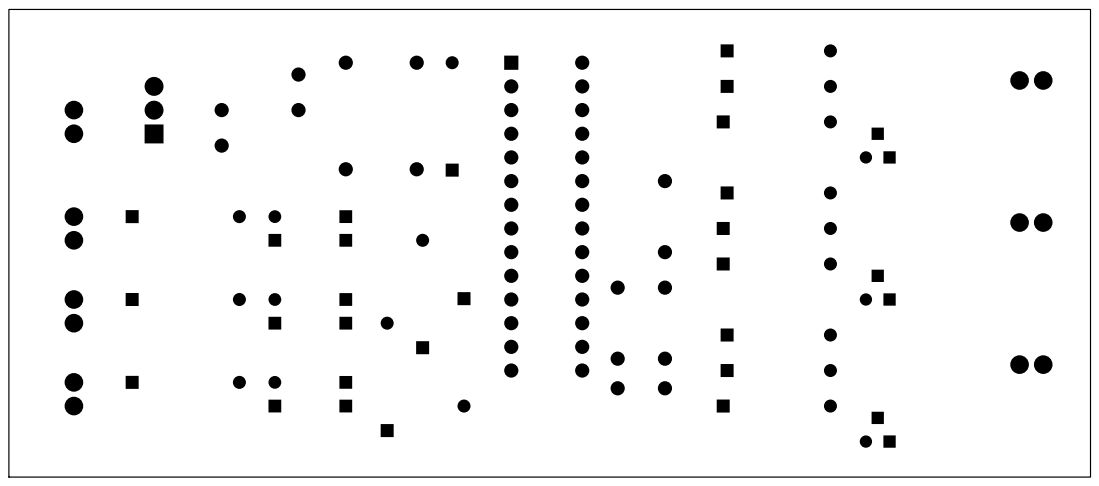
[picture p58: page 7]

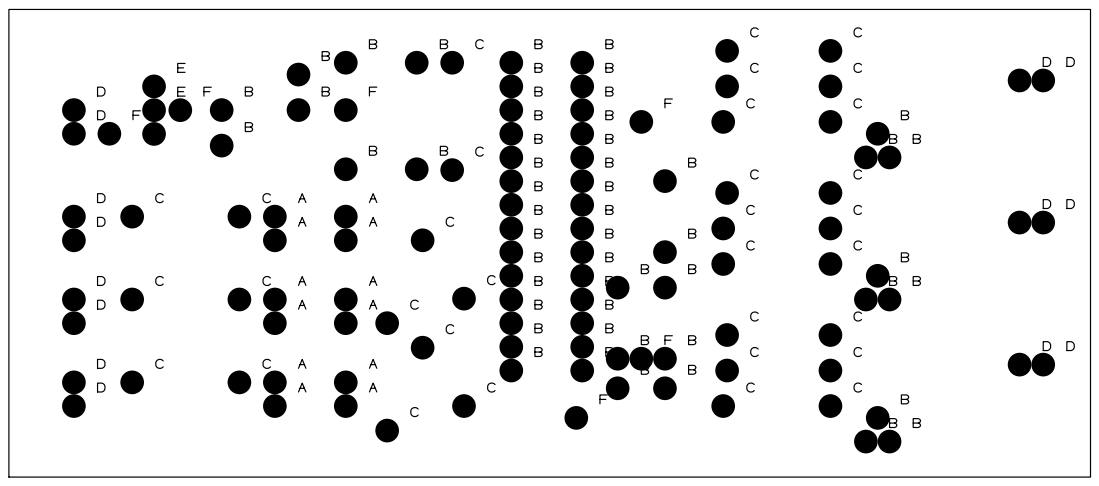
[picture p59: page 10]
