JabawokJayUK/ProjectHaloUK/hardware/schematic.pdf

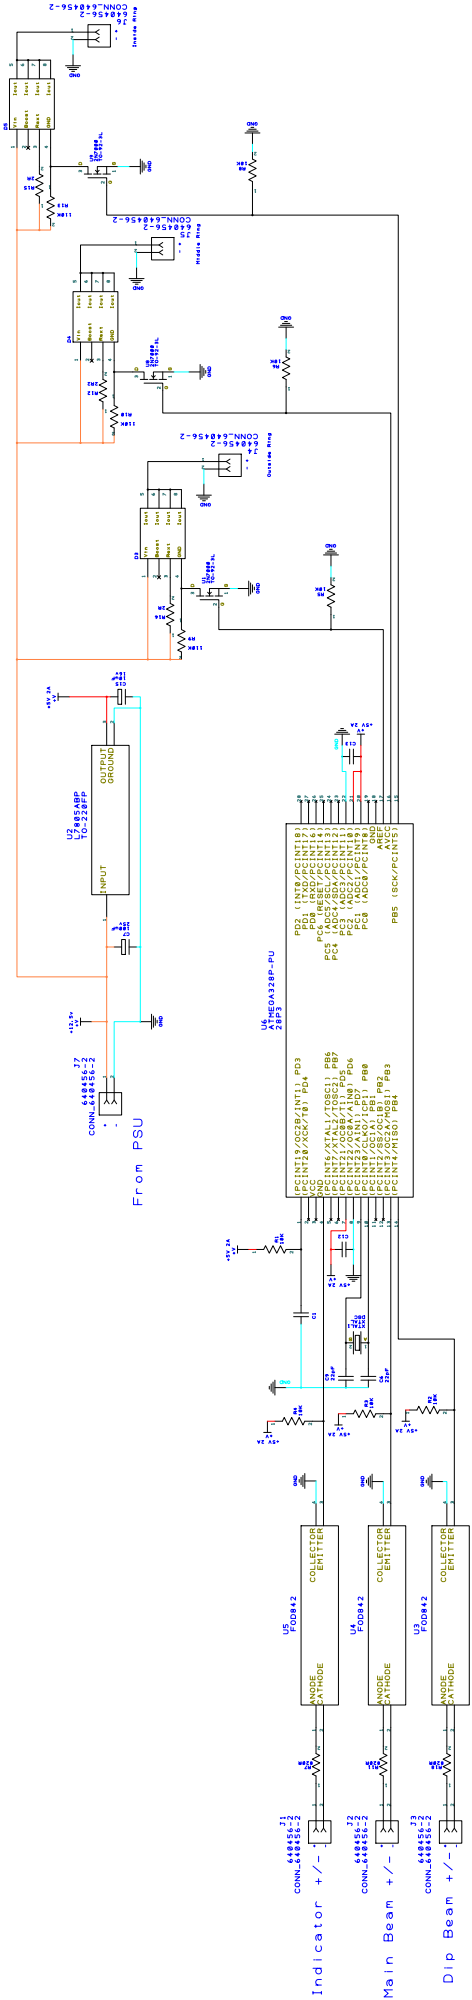
[picture p60: page 1]
