JabawokJayUK/ProjectHaloUK/(list of files, drawings)

Other design files:
hardware/designspark/Halo DS project.pcb
