JabawokJayUK/ProjectHaloUK/(commit log)

2026-10-17 Rebuild repo from recovered project documentation
    Reassembles the full Project Halo archive from three sources, two of
    which no longer exist: the projects.jabawoki.com MediaWiki (via the
    Internet Archive), the jabawoki.com project pages, and the 78-page
    Alfaowner.com build thread.
    - README rewritten; removes leftover forum BBCode, adds the project
    history, mode table, credits and safety notes
    - Adds 11 documentation pages: controller hardware (Pre-Alpha to v2.2),
    firmware notes, parts list, tools, vehicle applications, and six
    build guides (bumper removal, headlight splitting, ring installation,
    headlight wiring, power supplies, DIY delay-off relay, troubleshooting)
    - Adds 48 recove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
2026-10-18 Add hardware design files, firmware history, BOM and video index
    Imported from the original local project archive:
    - DesignSpark source, Gerbers and drill files (Halo Production V2, Oct 2013)
    - Schematic, PCB layout and 3D render PDFs
    - Bill of materials with RS/Farnell part numbers
    - Eight development sketches (HaloV1-V7)
    - 16 camera-original photographs, deduplicated and captioned
    Also: index of the nine Project Halo videos on YouTube, analysis of the
    post-handover fork, and credit to Matt Brown.
    [Halo DS project - Bottom Copper (Paste).gbr, Halo DS project - Bottom Copper (Resist).gbr, Halo DS project - Bottom Copper.gbr, Halo DS project - Bottom Documentation.gbr, Halo DS project - Bottom Silkscreen.gbr, Halo DS project - Drill Data - Through Hole (Unplated).drl, Halo DS project - Drill Data - Through Hole.drl, Halo DS project - Drill Ident Drawing - Through Hole.gbr]
2026-10-18 Remove misidentified image: forum attachment 171605
    Attachment ID 171605 was imported as the LED/regulator diagram. The forum
    CDN has reassigned that ID and now serves an unrelated vintage car advert.
    The original diagram is unrecoverable, so the reference is replaced with a
    note. All 48 forum-sourced images re-audited visually; this was the only
    bad one.
